jimfunk/goews-rebuilt-openscad/tile.scad

include <BOSL2/std.scad>
include <BOSL2/lists.scad>
include <BOSL2/threading.scad>

include <constants.scad>
include <parsers.scad>


/* [Primary parameters] */
// Which part variant to build
variant = 0; // [0: Original, 1: Thicker cleats]

// Tile columns in units
columns = 4;

// Tile rows in units
rows = 4;

// Fill top row
fill_top = false;

// Fill bottom row
fill_bottom = false;

// Fill left side
fill_left = false;

// Fill right side
fill_right = false;

// Reverse row stagger. This is useful for allowing tiles with odd numbers of rows to align with tiles with even numbers of rows at the top instead of the bottom
reverse_stagger = false;

// Make the tile the exact width of the tile columns. This causes every second row to have one less tile unit
exact_width = false;

// Mounting hole shank diameter
mounting_hole_shank_diameter = 4;

// Mounting hole head diameter
mounting_hole_head_diameter = 8;

// Mounting hole inset depth
mounting_hole_inset_depth = 1;

// Mounting hole countersink depth. Set to 0 to disable countersink
mounting_hole_countersink_depth = 2;

// List of tile positions to skip. Each entry is a pair of 1-based row and column coordinates with the origin at the lower left, eg: [1, 2], [3, 4]
skip_list = "";


/* [Hidden] */
$fa=0.5;
$fs=0.5;

// Small boolean overcut to avoid coplanar faces / zero-thickness STL scraps.
// These can show up in the browser preview as "filled" hanger windows even
// though slicers usually discard them.
bool_eps = 0.02;

module tile_cleat(variant=variant_original) {
    difference() {
        translate([0, 0, tile_hanger_cleat_width])
            union() {
                if (variant == variant_thicker_cleats) {
                    linear_extrude(height = cleat_offset)
                        square([tile_hanger_cleat_width, tile_hanger_cleat_lower_height + tile_hanger_cleat_width]);
                }
                rotate([270, 0, 0])
                    linear_extrude(height = tile_hanger_cleat_lower_height + tile_hanger_cleat_width)
                        polygon(
                            points=[
                                [0, 0],
                                [tile_hanger_cleat_width, 0],
                                [0, tile_hanger_cleat_width]
                            ]
                        );
            }
        linear_extrude(height = tile_hanger_cleat_width + cleat_offset)
            polygon(
                points = [
                    [0, tile_hanger_cleat_lower_height + tile_hanger_cleat_width],
                    [tile_hanger_cleat_width, tile_hanger_cleat_lower_height + tile_hanger_cleat_width],
                    [tile_hanger_cleat_width, tile_hanger_cleat_lower_height],
                ]
            );
    }
}


module mounting_hole(
    mounting_hole_shank_diameter=4,
    mounting_hole_head_diameter=8,
    mounting_hole_inset_depth=1,
    mounting_hole_countersink_depth=2,
) {
    // Overcut each cutter slightly so the mounting hole does not leave
    // coplanar scraps in the preview/STL. The overlaps are internal to the
    // subtracted shape and do not meaningfully change the printed dimensions.
    translate([0, 0, -bool_eps])
        cylinder(h=tile_thickness + 2 * bool_eps, d=mounting_hole_shank_diameter);

    translate([0, 0, tile_thickness - mounting_hole_inset_depth - bool_eps])
        cylinder(h=mounting_hole_inset_depth + 2 * bool_eps, d=mounting_hole_head_diameter);

    if (mounting_hole_countersink_depth > 0) {
        translate([0, 0, tile_thickness - mounting_hole_inset_depth + bool_eps])
            zcyl(
                h=mounting_hole_countersink_depth + 2 * bool_eps,
                d1=mounting_hole_shank_diameter,
                d2=mounting_hole_head_diameter,
                anchor=TOP
            );
    }
}


module hex_tile_single(
    variant=variant_original,
    mounting_hole_shank_diameter=4,
    mounting_hole_head_diameter=8,
    mounting_hole_inset_depth=1,
    mounting_hole_countersink_depth=2,
    cut_outside_corners=false,
    chamfer_rear=false,
    left_outside=false,
    left_inside=false,
    right_outside=false,
    right_inside=false,
    bottom=false,
    top=false,
    fill_bottom=false,
    fill_top=false,
    fill_left=false,
    fill_right=false
) {
    rear_cleat_thickness = variant == variant_original ? tile_hanger_rear_cleat_thickness : 0;
    cleat_additional_thickness = variant == variant_thicker_cleats ? cleat_offset : 0;
    hanger_x_offset = (tile_width - tile_hanger_width) / 2;
    tile_hanger_y_offset = tile_triangle_height;
    threaded_hole_center_x = tile_width / 2;
    threaded_hole_center_y = tile_height - tile_threaded_hole_y_offset;
    mounting_hole_center_x = tile_width / 2;
    mounting_hole_center_y = tile_mounting_hole_y_offset;

    difference() {
        // Outer hex tile
        translate([tile_width / 2, tile_width / sqrt(3), 0])
            rotate([0, 0, 90])
            diff() {
                regular_prism(n=6, h=tile_thickness, id=tile_width, center=false, chamfer2=0.5) {
                    tag("remove") {
                        if (cut_outside_corners && ((right_outside && !fill_right) || (right_inside && top && !fill_top && !fill_right))) {
                            attach("edge1")
                                translate([0, tile_thickness / 2, 0])
                                    cuboid([2, tile_thickness, .75]);
                        }
                        if (cut_outside_corners && right_outside && !fill_right && !(bottom && fill_bottom)) {
                            attach("edge2")
                                translate([0, tile_thickness / 2, 0])
                                    cuboid([2, tile_thickness, .75]);
                        }
                        if (cut_outside_corners && ((left_outside && !fill_left) || (left_inside && bottom && !fill_bottom && !fill_left))) {
                            attach("edge4")
                                translate([0, tile_thickness / 2, 0])
                                    cuboid([2, tile_thickness, .75]);
                        }
                        if (cut_outside_corners && left_outside && !fill_left && !(top &&  fill_top)) {
                            attach("edge5")
                                translate([0, tile_thickness / 2, 0])
                                    cuboid([2, tile_thickness, .75]);
                        }
                        if (chamfer_rear && ((right_outside && !fill_right) || (top && !fill_top))) {
                            attach("bot_edge0")
                                cuboid([tile_thickness, tile_width, 5]);
                        }
                        if (chamfer_rear && ((right_outside) || (right_inside && !fill_right))) {
                            attach("bot_edge1")
                                cuboid([tile_thickness, tile_width, 5]);
                        }
                        if (chamfer_rear && ((right_outside && !fill_right && !(bottom && fill_bottom)) || (bottom && !fill_bottom))) {
                            attach("bot_edge2")
                                cuboid([tile_thickness, tile_width, 5]);
                        }
                        if (chamfer_rear && ((left_outside && !fill_left) || (bottom && !fill_bottom))) {
                            attach("bot_edge3")
                                cuboid([tile_thickness, tile_width, 5]);
                        }
                        if (chamfer_rear && ((left_outside) || (left_inside && !fill_left))) {
                            attach("bot_edge4")
                                cuboid([tile_thickness, tile_width, 5]);
                        }
                        if (chamfer_rear && ((left_outside && !fill_left && !(top && fill_top)) || (top && !fill_top))) {
                            attach("bot_edge5")
                                cuboid([tile_thickness, tile_width, 5]);
                        }
                    }
                }
            }

	// Space for hanger
	translate([0, 0, -bool_eps])
	  linear_extrude(height=tile_thickness + 2 * bool_eps) difference() {
	  difference() {
	    translate([hanger_x_offset, tile_hanger_y_offset, 0])
	      square([tile_hanger_width, tile_hanger_height]);
	    translate([threaded_hole_center_x, threaded_hole_center_y, 0])
	      circle(tile_hanger_hole_outer_diameter);
	  }
	}

        // Threaded hole
        translate([threaded_hole_center_x, threaded_hole_center_y, 0])
            threaded_rod(
                d=thread_diameter + thread_tolerance,
                length=tile_thickness,
                pitch=thread_pitch,
                internal=true,
                blunt_start=false,
                anchor=BOTTOM
            );

        // Mounting hole
        translate([mounting_hole_center_x, mounting_hole_center_y, 0]) {
            mounting_hole(
                mounting_hole_shank_diameter=mounting_hole_shank_diameter,
                mounting_hole_head_diameter=mounting_hole_head_diameter,
                mounting_hole_inset_depth=mounting_hole_inset_depth,
                mounting_hole_countersink_depth=mounting_hole_countersink_depth
            );
        }
    }

    // Left rear chamfer
    translate([hanger_x_offset, tile_triangle_height, rear_cleat_thickness])
        rotate([90, 270, 180])
            linear_extrude(height = tile_hanger_height)
                polygon(
                    points=[
                        [0, 0],
                        [hanger_thickness / 2, 0],
                        [0, hanger_thickness / 2]
                    ]
                );

    // Left front cleat
    translate([hanger_x_offset, tile_hanger_y_offset, (hanger_thickness / 2) + rear_cleat_thickness])
        tile_cleat(variant=variant);

    // Right rear chamfer
    translate([tile_width - hanger_x_offset, tile_triangle_height + tile_hanger_height, rear_cleat_thickness])
        rotate([0, 270, 90])
            linear_extrude(height = tile_hanger_height)
                polygon(
                    points=[
                        [0, 0],
                        [hanger_thickness / 2, 0],
                        [0, hanger_thickness / 2],
                    ]
                );

    // Right front cleat
    translate([hanger_x_offset + tile_hanger_width, tile_hanger_y_offset, (hanger_thickness / 2) + rear_cleat_thickness])
        xflip() tile_cleat(variant=variant);

    // Lower rear chamfer
    translate([hanger_x_offset + tile_hanger_width, tile_triangle_height])
        rotate([0, 270, 0])
            linear_extrude(height = tile_hanger_width)
                polygon(
                    points=[
                        [0, 0],
                        [hanger_thickness - cleat_additional_thickness + rear_cleat_thickness, 0],
                        [0, hanger_thickness - cleat_additional_thickness + rear_cleat_thickness]
                    ]
                );

    // Rear cleats (Only for the original variant)
    if (variant == variant_original) {
        translate([1, tile_triangle_height, 0])
            linear_extrude(height = tile_hanger_rear_cleat_thickness)
                square([tile_hanger_rear_cleat_x_offset-1, tile_hanger_height]);
        translate([tile_width - tile_hanger_rear_cleat_x_offset, tile_triangle_height, 0])
            linear_extrude(height = tile_hanger_rear_cleat_thickness)
                square([tile_hanger_rear_cleat_x_offset - 1, tile_hanger_height]);
    }
}


module hex_fill_top(
    crop_left=false,
    crop_right=false,
    mounting_hole_shank_diameter=4,
    mounting_hole_head_diameter=8,
    mounting_hole_inset_depth=1,
    mounting_hole_countersink_depth=2,
    chamfer_rear=false
) {
    mounting_hole_center_x = tile_width / 2;
    mounting_hole_center_y = tile_mounting_hole_y_offset;

    difference() {
        // Body
        translate([tile_width / 2, tile_width / sqrt(3), 0])
            rotate([0, 0, 90])
                regular_prism(n=6, h=tile_thickness, id=tile_width, center=false, chamfer2=0.5);

        // Crop top
        translate([0, tile_triangle_height, 0])
            cube([tile_width, tile_height - tile_triangle_height, tile_thickness]);

        // Top chamfer
        translate([tile_width / 2, tile_triangle_height, tile_thickness])
            chamfer_edge_mask(l=tile_width, chamfer=0.5, orient=RIGHT);
        if (chamfer_rear) {
            translate([tile_width / 2, tile_triangle_height, 0])
                chamfer_edge_mask(l=tile_width, chamfer=0.5, orient=RIGHT);
        }

        if (! (crop_left || crop_right)) {
            // Mounting hole
            translate([mounting_hole_center_x, mounting_hole_center_y, 0]) {
                mounting_hole(
                    mounting_hole_shank_diameter=mounting_hole_shank_diameter,
                    mounting_hole_head_diameter=mounting_hole_head_diameter,
                    mounting_hole_inset_depth=mounting_hole_inset_depth,
                    mounting_hole_countersink_depth=mounting_hole_countersink_depth
                );
            }
        }

        if (crop_left) {
            // Crop left side
            translate([0, 0, 0])
                cube([tile_width / 2, tile_height, tile_thickness]);
            // Left chamfer
            translate([tile_width / 2, tile_height / 2, tile_thickness])
                chamfer_edge_mask(l=tile_height, chamfer=0.5, orient=FRONT);
            if (chamfer_rear) {
                translate([tile_width / 2, tile_height / 2, 0])
                    chamfer_edge_mask(l=tile_height, chamfer=0.5, orient=FRONT);
            }
        }

        if (crop_right) {
            // Crop right side
            translate([tile_width / 2, 0, 0])
                cube([tile_width / 2, tile_height, tile_thickness]);
            // Right chamfer
            translate([tile_width / 2, tile_height / 2, tile_thickness])
                chamfer_edge_mask(l=tile_height, chamfer=0.5, orient=FRONT);
            if (chamfer_rear) {
                translate([tile_width / 2, tile_height / 2, 0])
                    chamfer_edge_mask(l=tile_height, chamfer=0.5, orient=FRONT);
            }
        }
    }
}

module hex_fill_bottom(
    crop_left=false,
    crop_right=false,
    chamfer_rear=false
) {
    difference() {
        // Body
        translate([tile_width / 2, tile_triangle_height - (tile_height / 2), 0])
            rotate([0, 0, 90])
                regular_prism(n=6, h=tile_thickness, id=tile_width, center=false, chamfer2=0.5);

        // Crop bottom
        translate([0, -(tile_height - tile_triangle_height), 0])
            cube([tile_width, tile_height - tile_triangle_height, tile_thickness]);

        // Bottom chamfer
        translate([tile_width / 2, 0, tile_thickness])
            chamfer_edge_mask(l=tile_width, chamfer=0.5, orient=RIGHT);
        if (chamfer_rear) {
            translate([tile_width / 2, 0, 0])
                chamfer_edge_mask(l=tile_width, chamfer=0.5, orient=RIGHT);
        }

        if (crop_left) {
            // Crop left side
            translate([0, 0, 0])
                cube([tile_width / 2, tile_height, tile_thickness]);
            // Left chamfer
            translate([tile_width / 2, tile_height / 2, tile_thickness])
                chamfer_edge_mask(l=tile_height, chamfer=0.5, orient=FRONT);
            if (chamfer_rear) {
                translate([tile_width / 2, tile_height / 2, 0])
                    chamfer_edge_mask(l=tile_height, chamfer=0.5, orient=FRONT);
            }
        }

        if (crop_right) {
            // Crop right side
            translate([tile_width / 2, 0, 0])
                cube([tile_width / 2, tile_height, tile_thickness]);
            // Right chamfer
            translate([tile_width / 2, tile_height / 2, tile_thickness])
                chamfer_edge_mask(l=tile_height, chamfer=0.5, orient=FRONT);
            if (chamfer_rear) {
                translate([tile_width / 2, tile_height / 2, 0])
                    chamfer_edge_mask(l=tile_height, chamfer=0.5, orient=FRONT);
            }
        }
    }
}


module hex_fill_left(
    chamfer_rear=false,
    bottom=false,
    top=false,
    fill_bottom=false,
    fill_top=false,
    fill_left=false,
    fill_right=false
) {
    difference() {
        translate([0, tile_height / 2, 0])
            rotate([0, 0, 90])
                diff() {
                    regular_prism(n=6, h=tile_thickness, id=tile_width, center=false, chamfer2=0.5) {
                        tag("remove") {
                            if (chamfer_rear && bottom && !fill_bottom) {
                                attach("bot_edge2")
                                    cuboid([tile_thickness, tile_width, 5]);
                            }
                            if (chamfer_rear && top && !fill_top) {
                                attach("bot_edge0")
                                    cuboid([tile_thickness, tile_width, 5]);
                            }
                        }
                    }
                }
        translate([- (tile_width / 2), 0, 0])
            cube([tile_width / 2, tile_height, tile_thickness]);
        translate([0, tile_height / 2, tile_thickness])
            chamfer_edge_mask(l=tile_height, chamfer=0.5, orient=FRONT);
        if (chamfer_rear) {
            translate([0, tile_height / 2, 0])
                chamfer_edge_mask(l=tile_height, chamfer=0.5, orient=FRONT);
        }
    }
}


module hex_fill_right(
    chamfer_rear=false,
    bottom=false,
    top=false,
    fill_bottom=false,
    fill_top=false,
    fill_left=false,
    fill_right=false
) {
    difference() {
        translate([tile_width / 2, tile_height / 2, 0])
            rotate([0, 0, 90])
                diff() {
                    regular_prism(n=6, h=tile_thickness, id=tile_width, center=false, chamfer2=0.5) {
                        tag("remove") {
                            if (chamfer_rear && top && !fill_top) {
                                attach("bot_edge5")
                                    cuboid([tile_thickness, tile_width, 5]);
                            }
                        }
                    }
                }
        translate([(tile_width / 2), 0, 0])
            cube([tile_width / 2, tile_height, tile_thickness]);
        translate([tile_width / 2, tile_height / 2, tile_thickness])
            chamfer_edge_mask(l=tile_height, chamfer=0.5, orient=FRONT);
        if (chamfer_rear) {
            translate([tile_width / 2, tile_height / 2, 0])
                chamfer_edge_mask(l=tile_height, chamfer=0.5, orient=FRONT);
        }
    }
}


module tile(
    variant=variant_original,
    columns=4,
    rows=4,
    fill_top=false,
    fill_bottom=false,
    fill_left=false,
    fill_right=false,
    reverse_stagger=false,
    exact_width=false,
    mounting_hole_shank_diameter=4,
    mounting_hole_head_diameter=8,
    mounting_hole_inset_depth=1,
    mounting_hole_countersink_depth=2,
    skiplist=[],
    cut_outside_corners=true,
    chamfer_rear=true,
) {
    stagger_0 = reverse_stagger ? 1 : 0;
    stagger_1 = reverse_stagger ? 0 : 1;

    for (row = [0 : rows - 1]) {
        offset_x = (row % 2 == stagger_0) ? tile_width / 2 : 0;
        start_column = exact_width && (row % 2 == stagger_1) ? 1 : 0;
        row_fill_left = fill_left && ((exact_width && !offset_x) || (!exact_width && offset_x) ? true : false);
        row_fill_right = fill_right && (offset_x ? false : true);
        pos_y = row * tile_y_offset;
        bottom = row == 0;
        top = row == (rows - 1);

        for (column = [start_column : columns - 1]) {
            pos_x = offset_x + column * tile_width;

            // Determine outer corners and edges
            left_outside = (column == 0) && (row % 2 == stagger_1);
            left_inside = ((column == 0) && (row % 2 == stagger_0));
            right_outside = (column == (columns - 1)) && (row % 2 == stagger_0);
            right_inside = (column == (columns - 1)) && (row % 2 == stagger_1);

            if (!in_list([row + 1, column + 1], skiplist)) {
                translate([pos_x, pos_y, 0])
                    hex_tile_single(
                        variant=variant,
                        mounting_hole_shank_diameter=mounting_hole_shank_diameter,
                        mounting_hole_head_diameter=mounting_hole_head_diameter,
                        mounting_hole_countersink_depth=mounting_hole_countersink_depth,
                        mounting_hole_inset_depth=mounting_hole_inset_depth,
                        cut_outside_corners=cut_outside_corners,
                        chamfer_rear=chamfer_rear,
                        left_outside=left_outside,
                        left_inside=left_inside,
                        right_outside=right_outside,
                        right_inside=right_inside,
                        bottom=bottom,
                        top=top,
                        fill_bottom=fill_bottom,
                        fill_top=fill_top,
                        fill_left=fill_left,
                        fill_right=fill_right
                    );
            }
        }

        if (row_fill_left) {
            fill_offset_x = exact_width ? tile_width / 2 : 0;
            translate([fill_offset_x, pos_y, 0])
                hex_fill_left(
                    chamfer_rear=chamfer_rear,
                    bottom=bottom,
                    top=top,
                    fill_bottom=fill_bottom,
                    fill_top=fill_top,
                    fill_left=fill_left,
                    fill_right=fill_right
                );
        }

        if (row_fill_right) {
            translate([offset_x + tile_width * columns, pos_y, 0])
                hex_fill_right(
                    chamfer_rear=chamfer_rear,
                    bottom=bottom,
                    top=top,
                    fill_bottom=fill_bottom,
                    fill_top=fill_top,
                    fill_left=fill_left,
                    fill_right=fill_right
                );
        }

        if (fill_top && row == (rows - 1)) {
            // Fill in top row
            even_row = (row + 1) % 2 == stagger_0;
            offset_x = even_row ? tile_width / 2 : tile_width;

            for (column = [start_column : columns]) {
                pos_x = (offset_x + column * tile_width) - tile_width;
                pos_y = tile_y_offset * (row + 1);
                crop_left = column == start_column && !row_fill_left;
                crop_right = column == columns && !row_fill_right;
                translate([pos_x, pos_y, 0])
                    hex_fill_top(
                        crop_left=crop_left,
                        crop_right=crop_right,
                        mounting_hole_shank_diameter=mounting_hole_shank_diameter,
                        mounting_hole_head_diameter=mounting_hole_head_diameter,
                        mounting_hole_inset_depth=mounting_hole_inset_depth,
                        mounting_hole_countersink_depth=mounting_hole_countersink_depth,
                        chamfer_rear=chamfer_rear
                    );
            }
        }

        if (fill_bottom && row == 0) {
            // Fill in bottom row
            bottom_offset_x = offset_x - tile_width / 2;

            for (column = [start_column : columns]) {
                pos_x = (bottom_offset_x + column * tile_width);
                pos_y = tile_y_offset * (row);
                crop_left=column == start_column && !row_fill_left;
                crop_right=column == columns && !row_fill_right;
                translate([pos_x, pos_y, 0])
                    hex_fill_bottom(
                        crop_left=crop_left,
                        crop_right=crop_right,
                        chamfer_rear=chamfer_rear
                    );
            }
        }
    }
}


/*
 * Print time and filament use comparisons
 *
 * Original 6x6: 8 hours 2 minutes, 129g
 * Rebuilt original 6x6: 7 hours 3 minutes, 120g (7.0% reduction in filament)
 * Rebuilt thicker cleats 6x6: 6 hours 40 minutes, 111g (14.0% reduction in filament)
 *
 * Original 4x4: 3 hours 36 minutes, 58g
 * Original lite 4x4: 2 hours 54 minutes, 53g (8.6% reduction in filament)
 * Rebuilt original 4x4: 3 hours 11 minutes, 54g (6.9% reduction in filament)
 * Rebuilt thicker cleats 4x4: 3 hours 1 minute, 50g (13.8% reduction in filament)
 */


tile(
    variant=variant,
    columns=columns,
    rows=rows,
    fill_top=fill_top,
    fill_bottom=fill_bottom,
    fill_left=fill_left,
    fill_right=fill_right,
    reverse_stagger=reverse_stagger,
    exact_width=exact_width,
    mounting_hole_shank_diameter=mounting_hole_shank_diameter,
    mounting_hole_head_diameter=mounting_hole_head_diameter,
    mounting_hole_inset_depth=mounting_hole_inset_depth,
    mounting_hole_countersink_depth=mounting_hole_countersink_depth,
    skiplist=parse_vector_list(skip_list)
);
