jimfunk/goews-rebuilt-openscad/(list of files, cad)

Other CAD files:
gridfinity_shelf_module.scad
shelf.scad
