jimfunk/goews-rebuilt-openscad/(commit log)

2025-02-08 Initial checkin implementing hex tiles and hooks
    [GOEWS.scad, constants.scad, hanger.scad, hook.scad, parsers.scad, tile.scad]
2025-02-17 Added a web-based part generator
    [hanger.scad]
2025-02-18 Add bolt
    [GOEWS.scad, bolt.scad, constants.scad]
2025-02-21 Hanger plates can now expand to multiple GOEWS units
    [constants.scad, hanger.scad, hook.scad]
2025-02-21 Hooks parts can now have multiple hooks
    Also use async subprocesses
    [GOEWS.scad, hook.scad]
2025-02-22 Added rack generator
    [GOEWS.scad, rack.scad]
2025-02-23 Added tile edge support and fixed boolean parameters
    [GOEWS.scad, tile.scad]
2025-02-25 Tile mounting hole customization
    [GOEWS.scad, constants.scad, tile.scad]
2025-03-01 Added grid tiles
    Also added an option to cut hex tile corners but it is not exposed yet
    [GOEWS.scad, constants.scad, tile.scad]
2025-03-02 Chamfer the rear outside edges and corners slightly
    This makes for a better horizonal fit between tiles, ensuring that
    hangers that span across tiles insert easier.
    [constants.scad, tile.scad]
2025-03-02 Fix non-countersink mounting hole on top edge
    [tile.scad]
2025-03-08 Added shelves
    [GOEWS.scad, constants.scad, shelf.scad]
2025-03-08 Add bins and cups
    [GOEWS.scad, bin.scad, cup.scad, hanger.scad]
2025-03-15 Add Gridfinity shelves
    [GOEWS.scad, gridfinity.scad]
2025-03-16 Added a reverse stagger option to tiles
    [GOEWS.scad, tile.scad]
2025-03-22 Improve printability of thicker cleats cups and bins
    Added a small chamfer to the bottom of the hanger when thicker cleats is
    used and the hanger is above the build plate.
    [hanger.scad]
2025-04-15 Add an optional lip to hooks
    [GOEWS.scad, hook.scad]
2025-05-19 Added hanger mounts and cable clips
    Exposed hanger_tolerance to all parts and set defaults for all API
    fields.
    Improved the filename generation to avoid very long filenames.
    [GOEWS.scad, bin.scad, cableclip.scad, constants.scad, cup.scad, gridfinity.scad, hanger.scad, hook.scad]
2025-06-08 Added an exact width parameter to tiles
    [GOEWS.scad, tile.scad]
2025-07-26 Adjusted thicker cleats hanger offset to 0.65mm
    [constants.scad, hanger.scad]
2025-07-26 Bump the base hanger_offset to 0.75
    [constants.scad]
2025-09-07 Fix crop logic on fill_top
    [tile.scad]
2025-09-07 Add gridfinity shelf sides and front
    [GOEWS.scad, constants.scad, gridfinity.scad, hanger.scad]
2025-10-29 Added a max rear offset fillet option to gridfinity shelf to allow for longer rear offsets
    [GOEWS.scad, constants.scad, gridfinity.scad]
2025-10-30 Add new bolt head options
    [GOEWS.scad, bolt.scad, constants.scad]
2026-02-08 Fix inconsistent plate face introduced in afd11ab
    [constants.scad, tile.scad]
2026-04-14 Refactored scad, backend, and frontend. Added gridfinity bin
    [GOEWS.scad, bin.scad, bolt.scad, cableclip.scad, cup.scad, grid_tile.scad, gridfinity_bin.scad, gridfinity_shelf.scad]
2026-04-15 Use correct bolt_notch parameter in cup
    [cup.scad]
2026-05-28 Fix hanger.scad
    [hanger.scad]
2026-06-18 First cut
    [stacked_goews_tiles.scad]
2026-06-18 First cut of UI support
    [tile_stack.scad]
2026-06-18 Updated download options (tilestacks export zip files, not stls)
    [tile_stack.scad]
2026-06-18 Fix tile undercutting bug
    [tile.scad]
2026-06-18 Better overhang management on the separator layer
    [tile_stack.scad]
2026-06-18 Finesse separators
    [tile_stack.scad]
2026-11-13 Apply number parameter values as you type
    Number fields only wrote to the parameters on blur, so pressing Enter to
    submit the form generated with the stale value of the focused field, and
    the dirty state (Download button) didn't update until focus left the box.
    Claude-Session: https://claude.ai/code/session_01DBHDHHLCspKQt2cnzpjdUW
2026-11-13 Keep tile stack PETG separator off the tile openings
    The separator's hanger-window relief was a centered rectangle that left a
    2.5 mm lip on every side, and the threaded hole was cut 0.8 mm smaller
    than the hole. Where the lower tile has no top face (most of the window
    edge, the area beside the bolt boss, the screw-head inset and the
    threaded hole) that PETG was left hanging in mid-air.
    Cut the separator to match the lower tile's top face instead: the full
    hanger window minus the front cleat tops and the bolt pad, the threaded
    hole at its real radius, and the mounting hole at the screw-head inset.
    The lip and clearance settings remain for anyone who wants to extend the
    PETG, but default to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
